Jibhong/CheapChuController/README.md

### A Controller For That Specific Slider Game
