Jibhong/CheapChuController/CAD/ChuControllerAir.FCStd

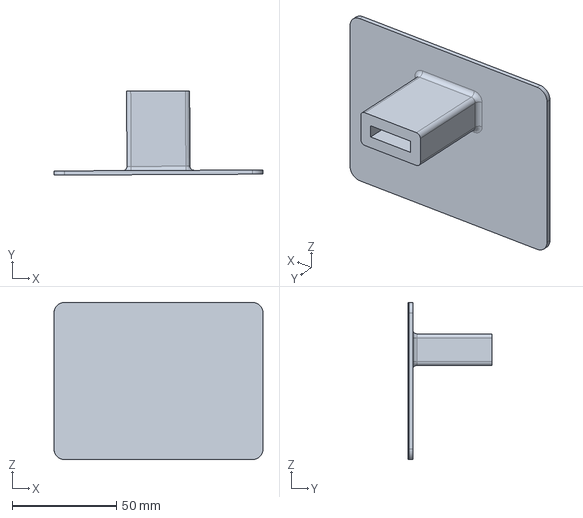
[picture p1: CAD file, 2026-08-11]
CAD/ChuControllerAir.FCStd
100.0 x 40.3 x 75.2 mm
