Jibhong/CheapChuController/PCB/ChuniController/ChuniController.kicad_pcb

## KiCad design PCB/ChuniController/ChuniController.kicad_pcb (2026-08-12)

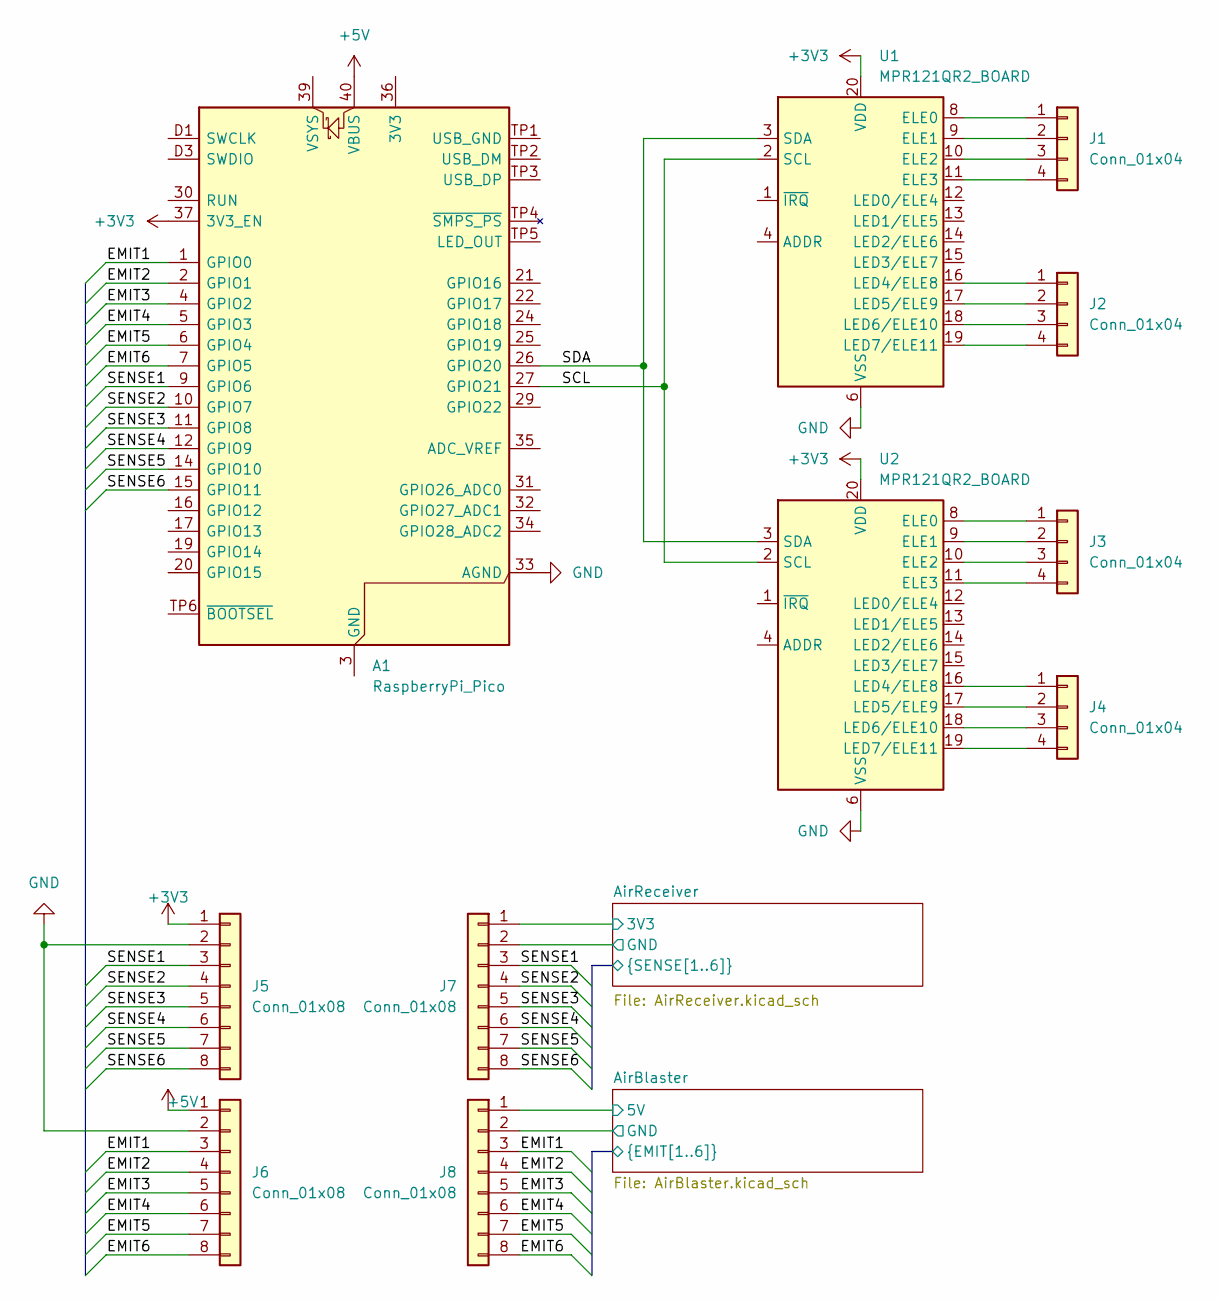
[picture p2: schematic ChuniController.kicad_sch]

Parts:
A1: RaspberryPi_Pico; RaspberryPi_Pico_SMD
J1, J2, J3: Conn_01x04
J4: Conn_01x04; JST_SH_SM04B-SRSS-TB_1x04-1MP_P1.00mm_Horizontal
J5, J6, J7, J8: Conn_01x08; JST_SH_SM08B-SRSS-TB_1x08-1MP_P1.00mm_Horizontal
U1, U2: MPR121QR2_BOARD; MPR121_BOARD

Connections:
+3V3: A1.37 (3V3_EN), J5.1, J7.1, U1.20 (VDD), U2.20 (VDD); also elsewhere on the board
+5V: A1.40 (VBUS), J6.1
/AirBlaster/5V: J8.1; also elsewhere on the board
/AirBlaster/EMIT1: A1.1 (GPIO0), J6.3, J8.3; also elsewhere on the board
/AirBlaster/EMIT2: A1.2 (GPIO1), J6.4, J8.4; also elsewhere on the board
/AirBlaster/EMIT3: A1.4 (GPIO2), J6.5, J8.5; also elsewhere on the board
/AirBlaster/EMIT4: A1.5 (GPIO3), J6.6, J8.6; also elsewhere on the board
/AirBlaster/EMIT5: A1.6 (GPIO4), J6.7, J8.7; also elsewhere on the board
/AirBlaster/EMIT6: A1.7 (GPIO5), J6.8, J8.8; also elsewhere on the board
/AirBlaster/GND: J8.2; also elsewhere on the board
/AirReceiver/SENSE1: A1.9 (GPIO6), J5.3, J7.3; also elsewhere on the board
/AirReceiver/SENSE2: A1.10 (GPIO7), J5.4, J7.4; also elsewhere on the board
/AirReceiver/SENSE3: A1.11 (GPIO8), J5.5, J7.5; also elsewhere on the board
/AirReceiver/SENSE4: A1.12 (GPIO9), J5.6, J7.6; also elsewhere on the board
/AirReceiver/SENSE5: A1.14 (GPIO10), J5.7, J7.7; also elsewhere on the board
/AirReceiver/SENSE6: A1.15 (GPIO11), J5.8, J7.8; also elsewhere on the board
/SCL: A1.27 (GPIO21), U1.2 (SCL), U2.2 (SCL)
/SDA: A1.26 (GPIO20), U1.3 (SDA), U2.3 (SDA)
GND: A1.33 (AGND), J5.2, J6.2, J7.2, U1.6 (VSS), U2.6 (VSS); also elsewhere on the board
unnamed: A1.3 (GND), A1.8 (GND), A1.13 (GND), A1.18 (GND), A1.23 (GND), A1.28 (GND), A1.38 (GND), A1.D2 (GND)
unnamed: J1.1, U1.8 (ELE0)
unnamed: J1.2, U1.9 (ELE1)
unnamed: J1.3, U1.10 (ELE2)
unnamed: J1.4, U1.11 (ELE3)
unnamed: J2.1, U1.16 (LED4/ELE8)
unnamed: J2.2, U1.17 (LED5/ELE9)
unnamed: J2.3, U1.18 (LED6/ELE10)
unnamed: J2.4, U1.19 (LED7/ELE11)
unnamed: J3.1, U2.8 (ELE0)
unnamed: J3.2, U2.9 (ELE1)
unnamed: J3.3, U2.10 (ELE2)
unnamed: J3.4, U2.11 (ELE3)
unnamed: J4.1, U2.16 (LED4/ELE8)
unnamed: J4.2, U2.17 (LED5/ELE9)
unnamed: J4.3, U2.18 (LED6/ELE10)
unnamed: J4.4, U2.19 (LED7/ELE11)

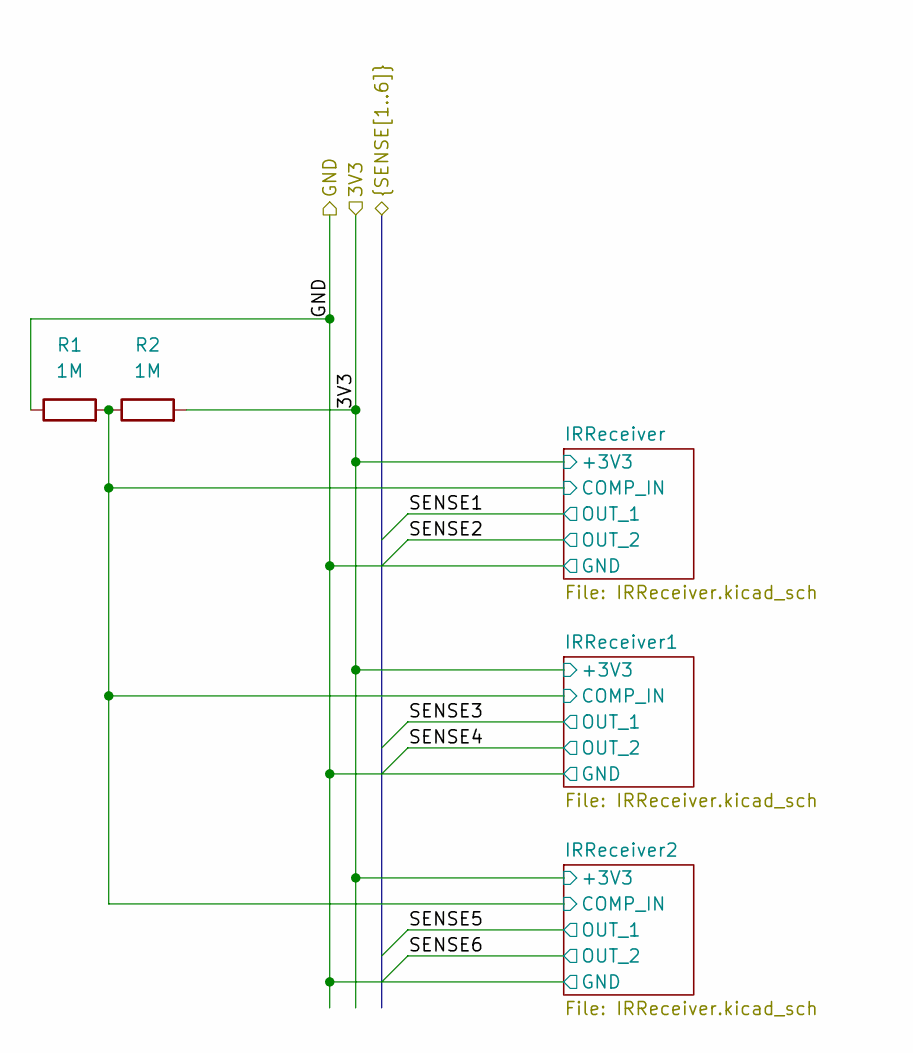
[picture p3: schematic AirReceiver.kicad_sch]

Parts:
R1, R2: 1M; R_0805_2012Metric_Pad1.20x1.40mm_HandSolder

Connections:
+3V3: R2.2; also elsewhere on the board
/AirReceiver/IRReceiver/COMP_IN: R1.2, R2.1; also elsewhere on the board
GND: R1.1; also elsewhere on the board

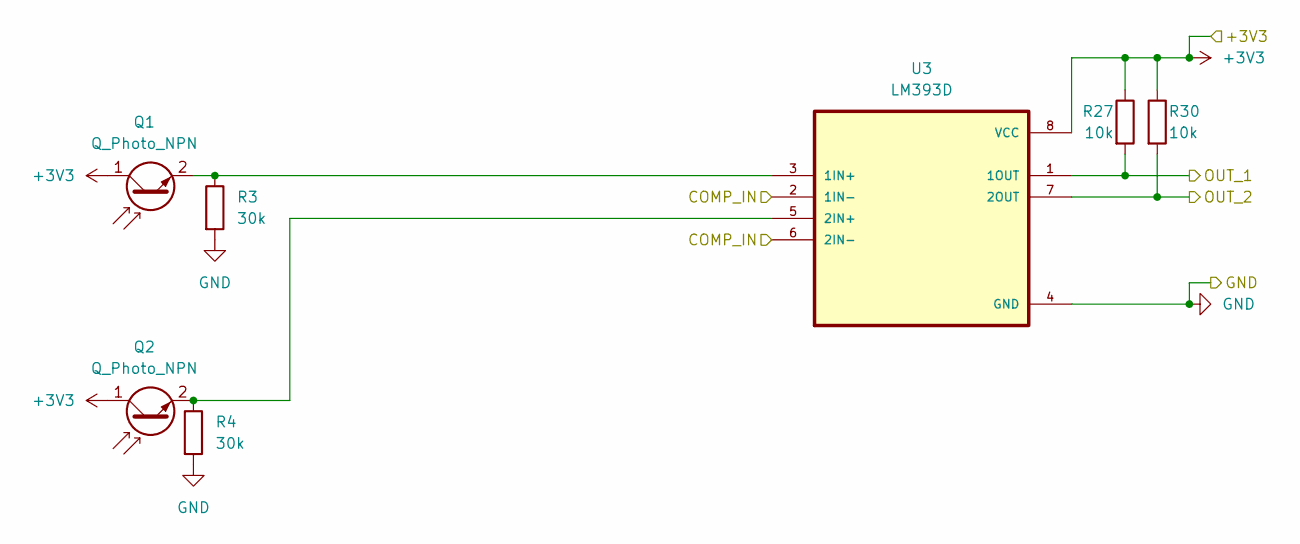
[picture p4: schematic IRReceiver.kicad_sch]

Parts:
Q1, Q2: Q_Photo_NPN; LED_D5.0mm
R3, R4: 30k; R_0805_2012Metric_Pad1.20x1.40mm_HandSolder
R27, R30: 10k; R_0805_2012Metric_Pad1.20x1.40mm_HandSolder
U3: LM393D; SOIC127P600X175-8N

Connections:
+3V3: Q1.1 (C), Q2.1 (C), R27.1, R30.1, U3.8 (VCC); also elsewhere on the board
/AirReceiver/IRReceiver/COMP_IN: U3.2 (1IN-), U3.6 (2IN-); also elsewhere on the board
/AirReceiver/SENSE1: R27.2, U3.1 (1OUT); also elsewhere on the board
/AirReceiver/SENSE2: R30.2, U3.7 (2OUT); also elsewhere on the board
GND: R3.2, R4.2, U3.4 (GND); also elsewhere on the board
unnamed: Q1.2 (E), R3.1, U3.3 (1IN+)
unnamed: Q2.2 (E), R4.1, U3.5 (2IN+)

Parts of its further copies:
Q3, Q4, Q5, Q6: Q_Photo_NPN; LED_D5.0mm
R5, R6, R7, R8: 30k; R_0805_2012Metric_Pad1.20x1.40mm_HandSolder
R28, R29, R31, R32: 10k; R_0805_2012Metric_Pad1.20x1.40mm_HandSolder
U4, U5: LM393D; SOIC127P600X175-8N

Connections of its further copies:
+3V3: Q3.1 (C), Q4.1 (C), Q5.1 (C), Q6.1 (C), R28.1, R29.1, R31.1, R32.1, U4.8 (VCC), U5.8 (VCC); also elsewhere on the board
/AirReceiver/IRReceiver/COMP_IN: U4.2 (1IN-), U4.6 (2IN-), U5.2 (1IN-), U5.6 (2IN-); also elsewhere on the board
/AirReceiver/SENSE3: R28.2, U4.1 (1OUT); also elsewhere on the board
/AirReceiver/SENSE4: R31.2, U4.7 (2OUT); also elsewhere on the board
/AirReceiver/SENSE5: R29.2, U5.1 (1OUT); also elsewhere on the board
/AirReceiver/SENSE6: R32.2, U5.7 (2OUT); also elsewhere on the board
GND: R5.2, R6.2, R7.2, R8.2, U4.4 (GND), U5.4 (GND); also elsewhere on the board
unnamed: Q3.2 (E), R5.1, U4.3 (1IN+)
unnamed: Q4.2 (E), R6.1, U4.5 (2IN+)
unnamed: Q5.2 (E), R7.1, U5.3 (1IN+)
unnamed: Q6.2 (E), R8.1, U5.5 (2IN+)

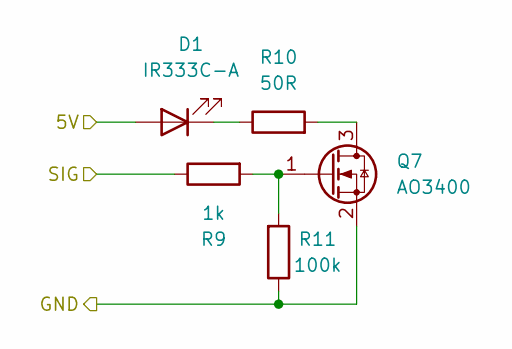
[picture p5: schematic IRBlaster.kicad_sch]

Parts:
D1: IR333C-A; LED_D5.0mm
Q7: AO3400; SOT-23
R9: 1k; R_0805_2012Metric_Pad1.20x1.40mm_HandSolder
R10: 50R; R_0805_2012Metric_Pad1.20x1.40mm_HandSolder
R11: 100k; R_0805_2012Metric_Pad1.20x1.40mm_HandSolder

Connections:
/AirBlaster/5V: D1.2 (A); also elsewhere on the board
/AirBlaster/EMIT1: R9.1; also elsewhere on the board
/AirBlaster/GND: Q7.2 (S), R11.1; also elsewhere on the board
unnamed: D1.1 (K), R10.1
unnamed: Q7.3 (D), R10.2
unnamed: Q7.1 (G), R9.2, R11.2

Parts of its further copies:
D2, D3, D4, D5, D6: IR333C-A; LED_D5.0mm
Q8, Q9, Q10, Q11, Q12: AO3400; SOT-23
R12, R15, R18, R21, R24: 1k; R_0805_2012Metric_Pad1.20x1.40mm_HandSolder
R13, R16, R19, R22, R25: 50R; R_0805_2012Metric_Pad1.20x1.40mm_HandSolder
R14, R17, R20, R23, R26: 100k; R_0805_2012Metric_Pad1.20x1.40mm_HandSolder

Connections of its further copies:
/AirBlaster/5V: D2.2 (A), D3.2 (A), D4.2 (A), D5.2 (A), D6.2 (A); also elsewhere on the board
/AirBlaster/EMIT2: R12.1; also elsewhere on the board
/AirBlaster/EMIT3: R15.1; also elsewhere on the board
/AirBlaster/EMIT4: R18.1; also elsewhere on the board
/AirBlaster/EMIT5: R21.1; also elsewhere on the board
/AirBlaster/EMIT6: R24.1; also elsewhere on the board
/AirBlaster/GND: Q8.2 (S), Q9.2 (S), Q10.2 (S), Q11.2 (S), Q12.2 (S), R14.1, R17.1, R20.1, R23.1, R26.1; also elsewhere on the board
unnamed: D2.1 (K), R13.1
unnamed: D3.1 (K), R16.1
unnamed: D4.1 (K), R19.1
unnamed: D5.1 (K), R22.1
unnamed: D6.1 (K), R25.1
unnamed: Q8.3 (D), R13.2
unnamed: Q8.1 (G), R12.2, R14.2
unnamed: Q9.3 (D), R16.2
unnamed: Q9.1 (G), R15.2, R17.2
unnamed: Q10.3 (D), R19.2
unnamed: Q10.1 (G), R18.2, R20.2
unnamed: Q11.3 (D), R22.2
unnamed: Q11.1 (G), R21.2, R23.2
unnamed: Q12.3 (D), R25.2
unnamed: Q12.1 (G), R24.2, R26.2

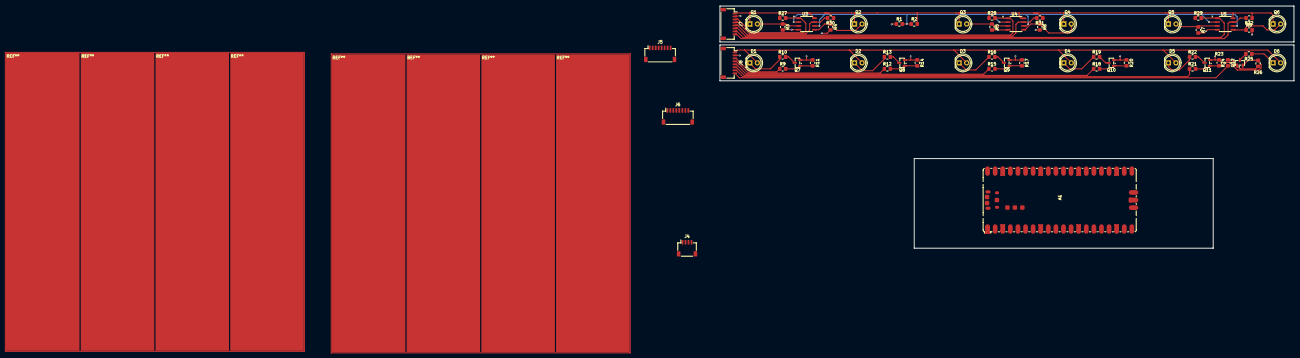
[picture p6: board ChuniController.kicad_pcb from above]

Board: 2 copper layers, 192.0 x 81.0 mm, 59 parts (0 on the bottom side), 43 nets.
