Jibhong/CheapChuController/(commit log)

2026-07-30 Compatable with Raspberry pi pico 2
2026-07-31 Feat: Communication with game sucessful Test: connect GPIO 16 to GND for air 0 1 2 and slider 0 1 2
2026-08-01 Reduce slider to only on and off Added Coin Service Test Button
2026-08-05 Add touch sensor
    [ChuniController.kicad_pcb, ChuniController.kicad_sch]
2026-08-05 Add PCB
    [ChuniController.kicad_pcb, ChuniController.kicad_sch]
2026-08-06 Add IR sensor
    [ChuniController.kicad_pcb, ChuniController.kicad_sch]
2026-08-09 Seperate schematic to multiple page
    [AirReceiver.kicad_sch, ChuniController.kicad_sch, IRReceiver.kicad_sch, ir_sensor.kicad_sch, untitled.kicad_sch]
2026-08-11 PCB + CAD
    [AirBlaster.kicad_sch, AirReceiver.kicad_sch, ChuControllerAir.FCStd, ChuniController.kicad_pcb, ChuniController.kicad_sch, IRBlaster.kicad_sch, IRReceiver.kicad_sch]
2026-08-12 PCB Add pullup 10kR in LM393D reduce AO3400 pulldown to 10kR
    [IRBlaster.kicad_sch, IRReceiver.kicad_sch]
2026-08-12 Temporary air for one sensor
2026-08-12 PCB both ir board: ok add LM393D 3d model
    [AirBlaster.kicad_sch, AirReceiver.kicad_sch, ChuniController.kicad_pcb, ChuniController.kicad_sch, IRBlaster.kicad_sch, IRReceiver.kicad_sch]
2026-09-12 LED when input More sensitive Keyboardio for some game
